murphyDeffa/SEPLOS_10kWh/BMS_3.0.jpg

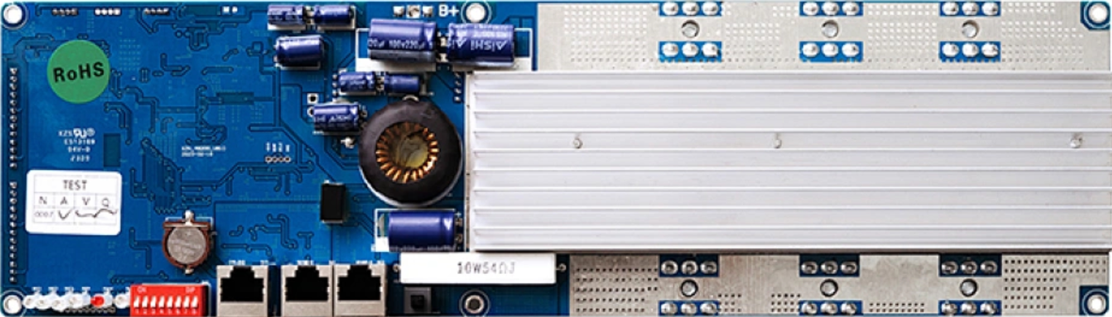
BMS_3.0.jpg
