murphyDeffa/SEPLOS_10kWh/bat1.jpg

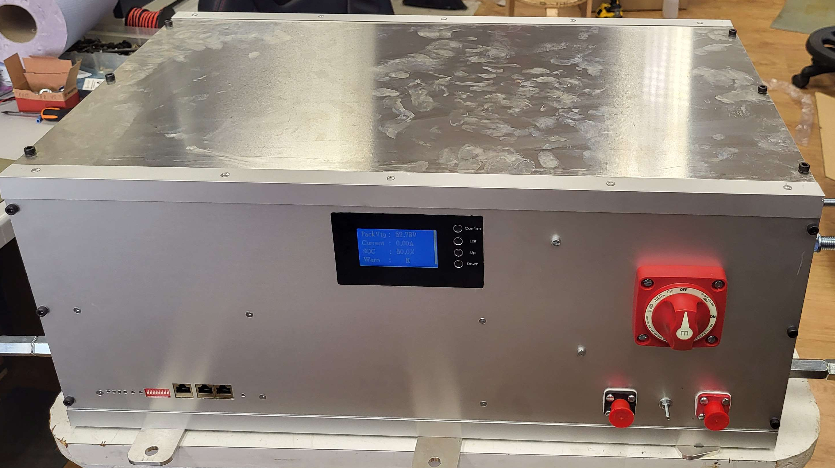
bat1.jpg
