murphyDeffa/SEPLOS_10kWh/bat3.jpg

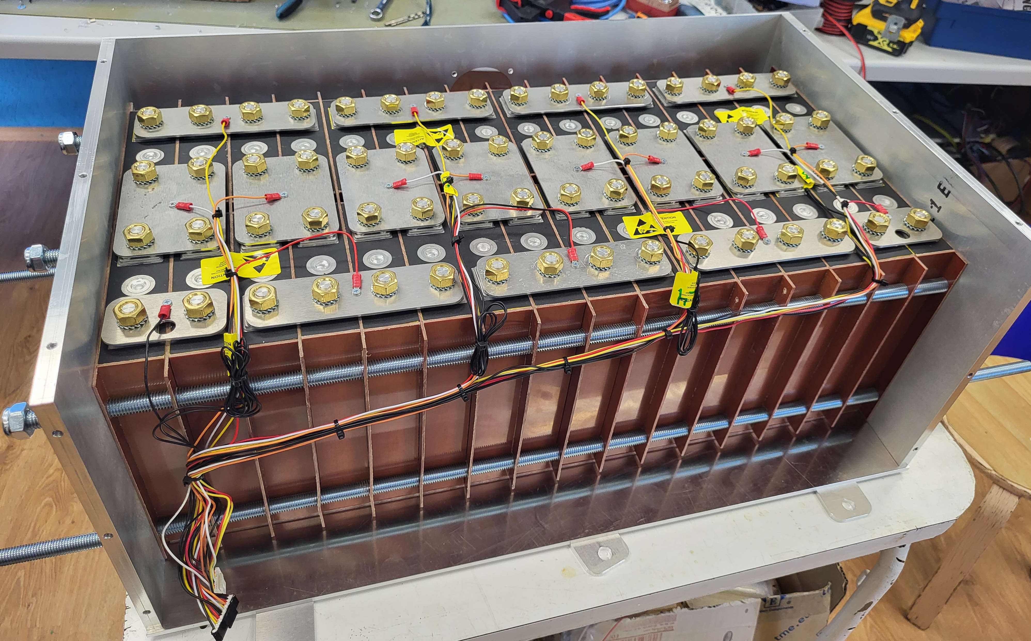
bat3.jpg
