murphyDeffa/SEPLOS_10kWh/esi_paneel.jpg

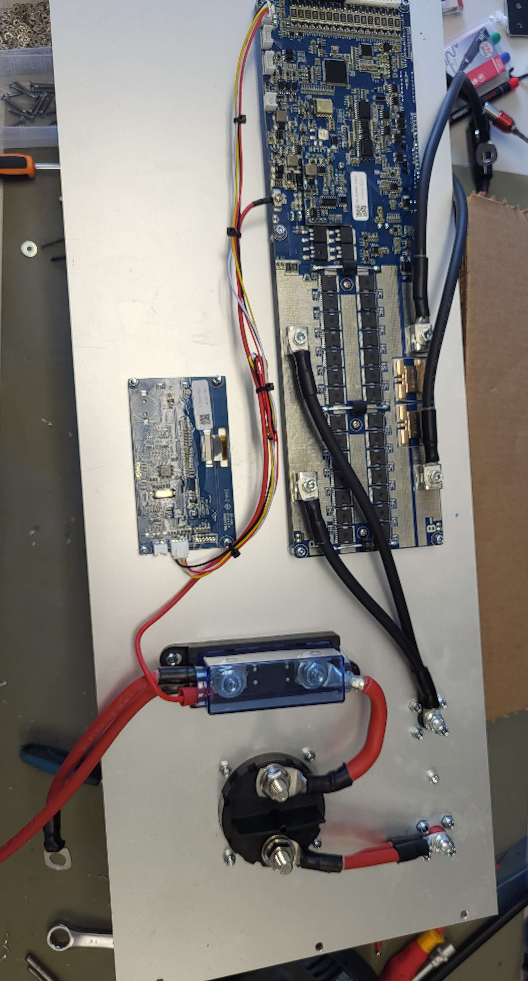
esi_paneel.jpg
