murphyDeffa/SEPLOS_10kWh/EX-L100_24V.jpg

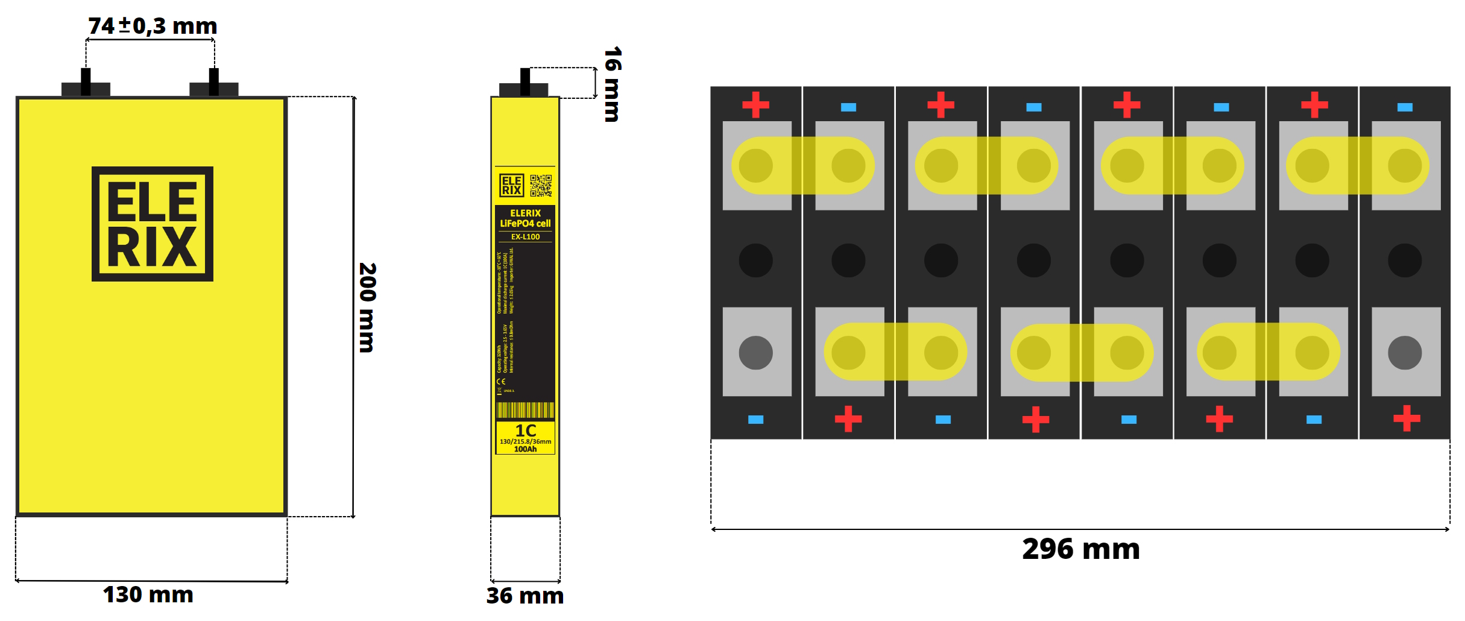
EX-L100_24V.jpg
