murphyDeffa/SEPLOS_10kWh/LDC_draw.jpg

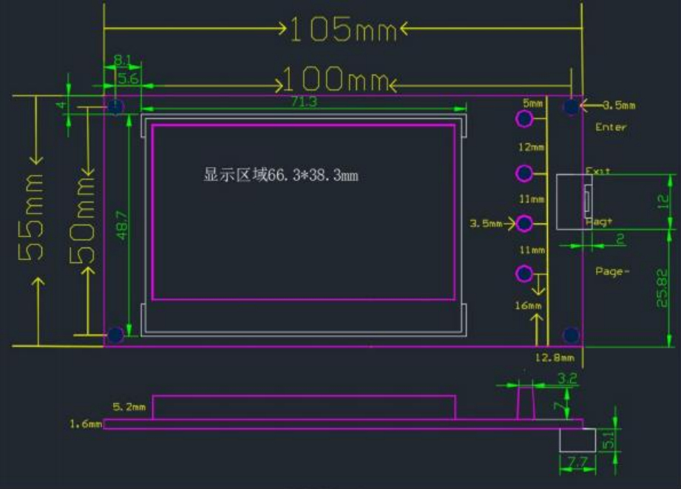
LDC_draw.jpg
