murphyDeffa/SEPLOS_10kWh/BOM.xlsx

Komponent | Kogus | Tootekood | Comment | Tarnija | Link
Tesa kahepoole teip 15-20mm | 1 rull | Aku elementide ja separaatorite vahel | punane | estpack
Nolax Aluminium comp. |  | Aku terminali ja büsbar vahel | ekvalentsed tooted leitavad eestis | amazon | https://www.amazon.com/Noalox-Anti-oxidant-Compound-Oz-Bottle/dp/B0019KHHRE
Locktight keermeliim sinine |  | kõik kinnitused v.a. Elektrilised ühendused | ekvalentsed tooted leitavad eestis | amazon | https://www.amazon.com/ThreadLocker-Fasteners-Anaerobic-Loosening-Corrosion/dp/B0CZ4GZZYH?th=1
CAD
Front_Panel | 1 | 3mm Al |  | Eccom | https://eccom.ee/
Back_Panel | 1 | 3mm Al |  | Eccom | https://eccom.ee/
Top_Panel | 1 | 3mm Al |  | Eccom | https://eccom.ee/
Bottom_Panel | 1 | 5mm Al |  | Eccom | https://eccom.ee/
End_Plate | 2 | 10mm Al |  | Eccom | https://eccom.ee/
Bus_Bar1 | 2 | 3mm Al | Anodeerimata!! | Eccom | https://eccom.ee/
Bus_Bar2 | 8 | 3mm Al | Anodeerimata!! | Eccom | https://eccom.ee/
Bus_Bar3 | 7 | 3mm Al | Anodeerimata!! | Eccom | https://eccom.ee/
Separator1 | 1 | 2mm klaas/riide tekstoliit |  | Eccom | https://eccom.ee/
Separator2 | 17 | 2mm klaas/riide tekstoliit |  | Eccom | https://eccom.ee/
Separator3 | 64 | 2mm klaas/riide tekstoliit | laius mitte väiksem kui mudelis | Eccom | https://eccom.ee/
Spacer | 6 | 0,5-1mm pleks | aku paki laiuse reguleerimiseks, kogu laius peab olema 635mm
Kinnitusmaterjalid
Al 15x15 L profiil, dekoratiivne 1M | 4 |  |  | ehituspood
3,2mm 10mm neet | 20 |  | L-profiil iluliistude kinnitamiseks | ehituspood
M10 bimetall seib. | 4 | ALCU10CS2 | Väljund terminalide vahele. | Kalitec | https://www.kabelschuhe-shop.de/Kalitec-ALCU10CS2
M10 Al pronks mutter | 64 | komplektis aku elemendiga | 20Nm momentvõtmega
10mm lukustus seib | 64 |  |  | tme
M4x10mm | 14 |  | esipaneeli pesad, kaitse, lüliti | tme
M4 lukustusmutter | 2 |  | kaise
M3x4mm | 27 | 1375547 | sense juhtmed, BMS, BMS_LCD | tme | https://www.tme.eu/ee/details/b3x4_bn388/kruvid/bossard/1375547/
M3x15mm spacer S/V | 6 | 213X15 | BMS |  | https://www.tme.eu/ee/details/tfm-m3x15_dr213/metallpuksid/dremec/213x15/
M3 spacer | 4 |  | BMS_LCD
M3 lukustusmutter | 10 |  | BMS,BMS_LCD
M12 keermelatt 1M | 6 |  | paki koos hoidvad latid | ehituspood
M12 mutter | 12 |  | paki koos hoidvad latid, 5Nm!! Keermelati kohta | ehituspood
M12 lukustus mutter | 10 |  | paki koos hoidvad latid, keerata jõuga mitte lukustuva mutri vastu | ehituspood
M12 seib | 12 |  | paki koos hoidvad latid | ehituspood
M12 pikendusmutter | 8 |  | paki koos hoidvad latid, 2 pikemat latti käepideme jaoks | ehituspood
1,5mm2 8mm kaabliking | 1 |  | BMS toide | akuladu | https://akuladu.ee/toode/juhtme-ots-680-kollane-m10/
10mm2 5mm Kaabliking | 4 |  | BMS |  | https://akuladu.ee/toode/klemm-starteri-cu-5-10/
10mm2 6mm Kaabliking | 4 |  | Esipaneel pesad | akuladu | https://akuladu.ee/toode/klemm-starteri-cu-6-10/
10mm2 8mm Kaabliking | 2 |  | kaitse | akuladu | https://akuladu.ee/toode/klemm-starteri-cu-8-10/
10mm2 10mm Kaabliking | 6 | BM 02443 | battery term. Switch | tme | https://www.tme.eu/ee/details/bm02443/isoleerimata-konnektorid/bm-group/bm-02443/
25mm2 10mm kaabliking | 1 |  | lüliti | akuladu | https://akuladu.ee/toode/klemm-starteri-cu-10-25/
25mm2 8mm kaabliking | 1 |  | kaitse | akuladu | https://akuladu.ee/toode/klemm-starteri-cu-8-25/
10mm2 kaabel punane | 1m |  | sisemised pos. ühendused | akuladu | https://akuladu.ee/toode/kaabel-kummi-10mm2-hi-flex-punane/
10mm2 kaabel must | 1m |  | sisemised neg. Ühendused | akuladu | https://akuladu.ee/toode/kaabel-kummi-10mm2-hi-flex-must/
25mm2 kaabel punane | x |  | lüliti - kaitse. Väljuv -pos. Ühendus, pikkus vastavalt vajadusele | akuladu | https://akuladu.ee/toode/kaabel-kummi-25mm2-hi-flex-punane/
25mm2 kaabel must | x |  | Väljuv neg. Ühendus, pikkus vastavalt vajadusele | akuladu | https://akuladu.ee/toode/kaabel-kummi-25mm2-hi-flex-must/
Elektroonika
EX-L100 | 32 |  |  |  | https://www.i4wifi.eu/en/298853-elerix-ex-l100
Seoplos BMS 3.0 100A LiFePo LCD | 1 |  |  | SEPLOS
Victron Fuse holder for MEGA-fuse | 1 | CIP000100001 |  | akuladu | https://akuladu.ee/toode/victron-fuse-holder-for-mega-fuse/
Victron MEGA-fuse 200A/32V | 1 |  |  | akuladu | https://akuladu.ee/toode/victron-mega-fuse-200a-32v/
must esipaneeli pesa | 1 | SLPRATPSB |  | mouser | https://www.mouser.ee/ProductDetail/Amphenol-Industrial/SLPRATPSB?qs=Rmyl20M3OaDqadhFFYsKQQ%3D%3D
punane esipaneeli pesa | 1 | SLPRATPSR |  | mouser | https://www.mouser.ee/ProductDetail/Amphenol-Industrial/SLPRATPSR?qs=Rmyl20M3OaBR9uqyp%252BGgEA%3D%3D
must pistik 25mm2 kaablile | 1 | SLPPA25BSB |  | mouser
punane pistik 25mm2 kaablile | 1 | SLPPA25BSR |  | mouser
Toitelüliti | 1 |  |  | akuladu | https://akuladu.ee/toode/massiluliti-12-48v-300a-1500a/
