murphyDeffa/SEPLOS_10kWh/Battery_Back.SLDASM

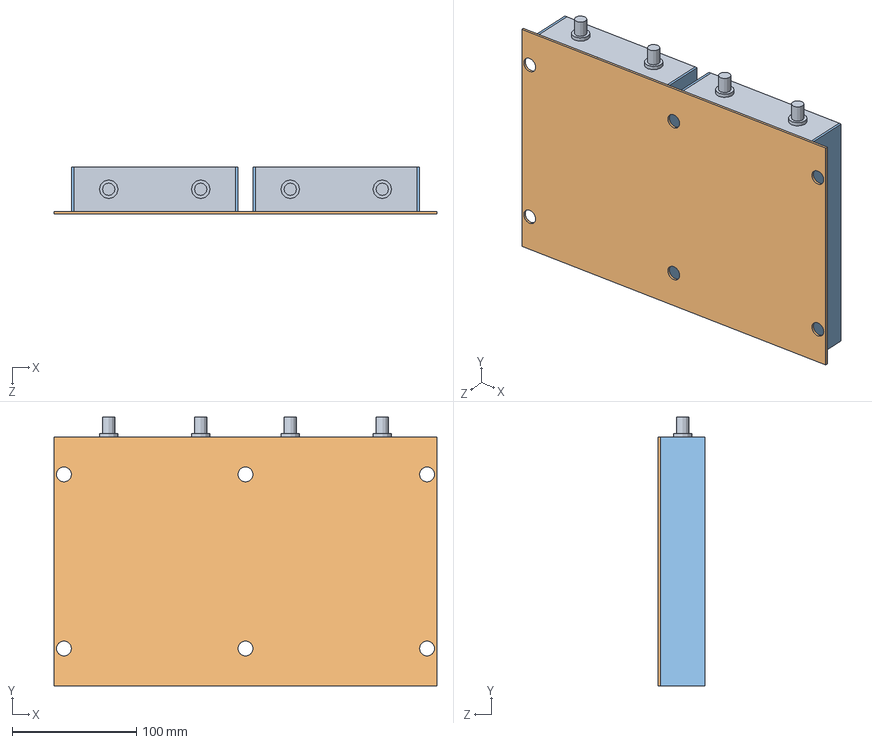
[picture p7: CAD file, 2025-07-07]
Battery_Back.SLDASM
308.0 x 216.0 x 38.0 mm
Battery x 2
Separator2
Separator3 x 4
