murphyDeffa/SEPLOS_10kWh/Spacer.STEP

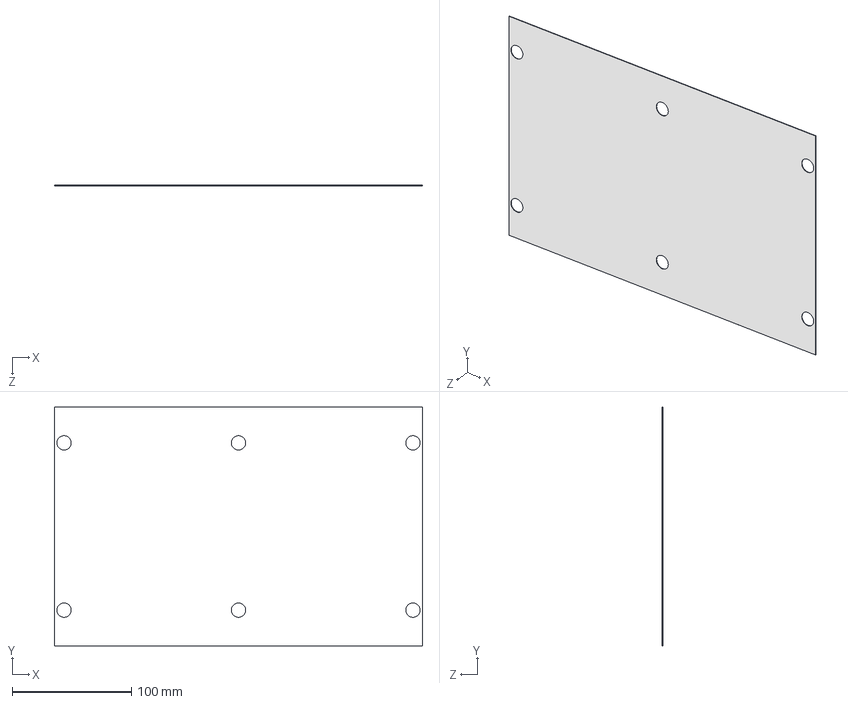
[picture p8: CAD file, 2025-07-06]
Spacer.STEP
308.0 x 200.0 x 0.5 mm
