murphyDeffa/SEPLOS_10kWh/Front_Panel.STEP

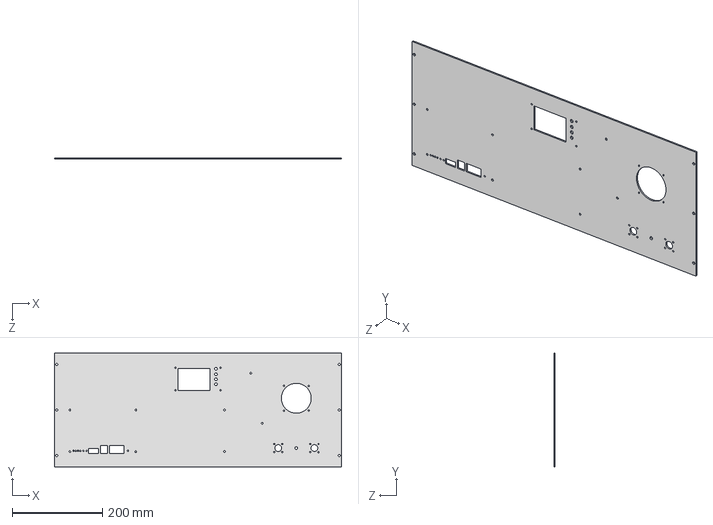
[picture p9: CAD file, 2025-07-06]
Front_Panel.STEP
635.0 x 252.0 x 3.00 mm
