murphyDeffa/SEPLOS_10kWh/Battery_Pack32.STEP

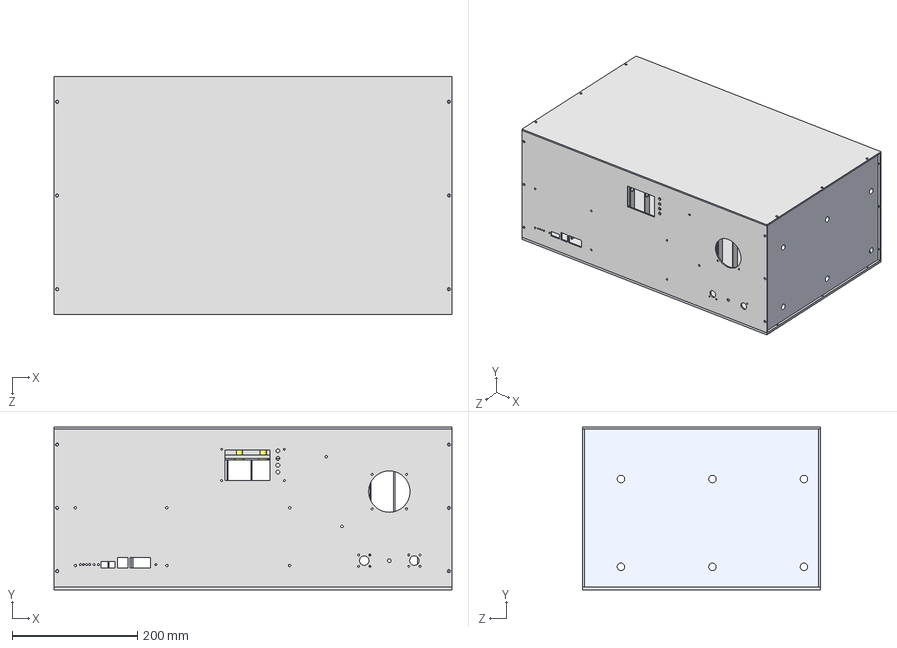
[picture p10: CAD file, 2025-07-06]
Battery_Pack32.STEP
635.0 x 260.0 x 379.0 mm
Battery x 32
Separator2 x 17
Separator3 x 64
End_Plate x 2
Separator1
Bus_Bar1 x 2
Bus_Bar2 x 8
Bus_Bar3 x 7
Front_Panel
Read_Panel
Bottom_Panel
Top_Panel
