murphyDeffa/SEPLOS_10kWh/Bus_Bar1.STEP

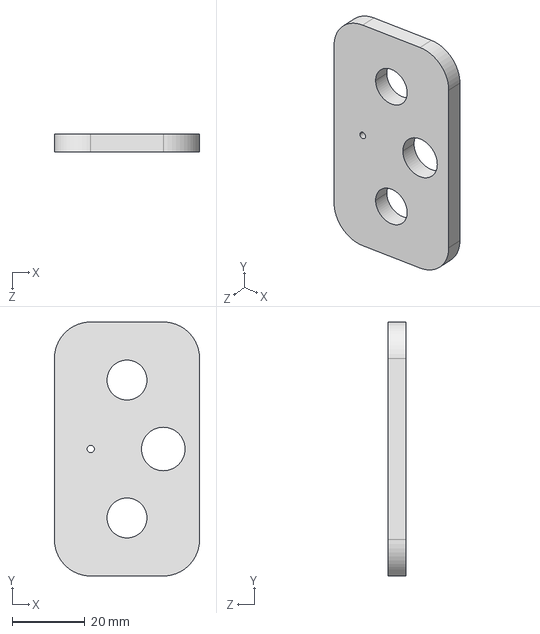
[picture p11: CAD file, 2025-07-06]
Bus_Bar1.STEP
40.0 x 70.0 x 5.00 mm
