murphyDeffa/SEPLOS_10kWh/Bottom_Panel.STEP

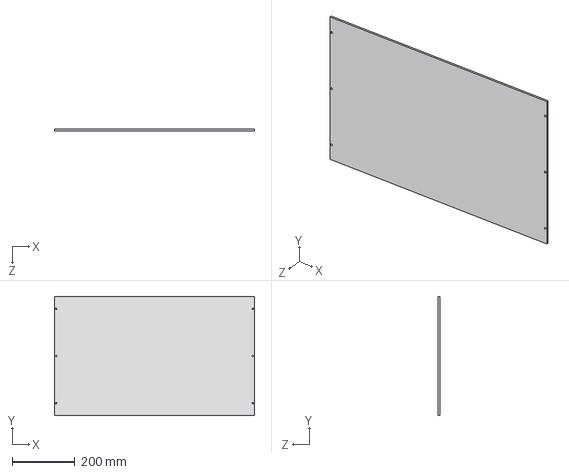
[picture p12: CAD file, 2025-07-06]
Bottom_Panel.STEP
635.0 x 379.0 x 5.00 mm
