murphyDeffa/SEPLOS_10kWh/Top_Panel.STEP

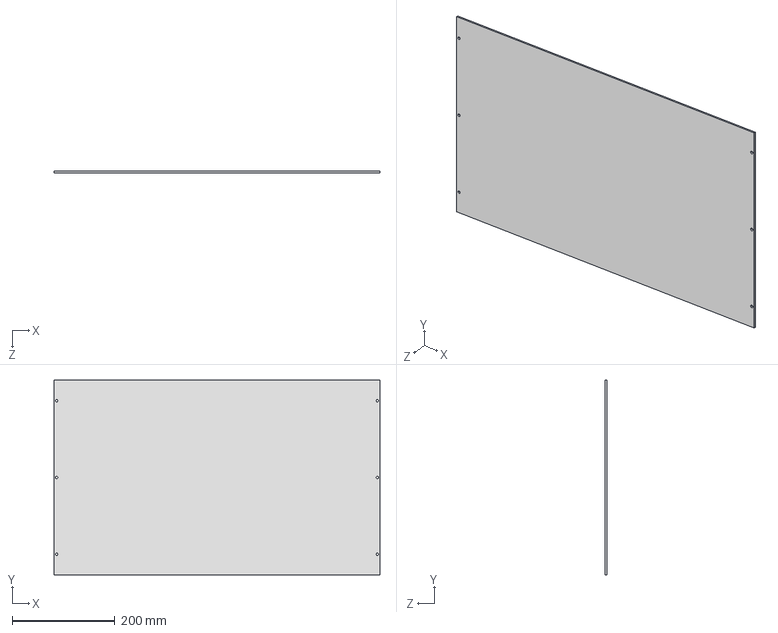
[picture p13: CAD file, 2025-07-06]
Top_Panel.STEP
635.0 x 379.0 x 3.00 mm
