murphyDeffa/SEPLOS_10kWh/Separator1.STEP

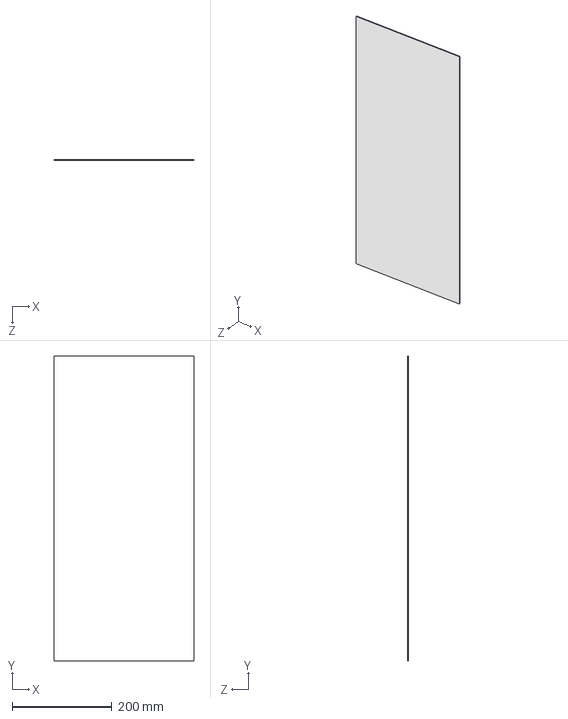
[picture p14: CAD file, 2025-07-06]
Separator1.STEP
280.0 x 610.0 x 2.00 mm
