murphyDeffa/SEPLOS_10kWh/Separator3.STEP

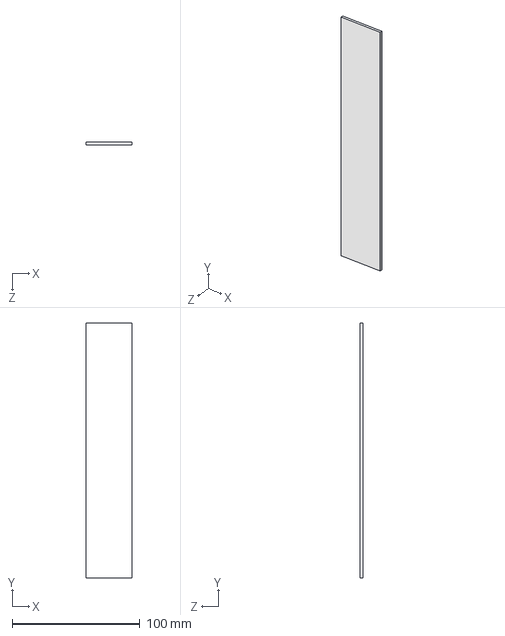
[picture p15: CAD file, 2025-07-06]
Separator3.STEP
36.0 x 200.0 x 2.00 mm
