murphyDeffa/SEPLOS_10kWh/End_Plate.STEP

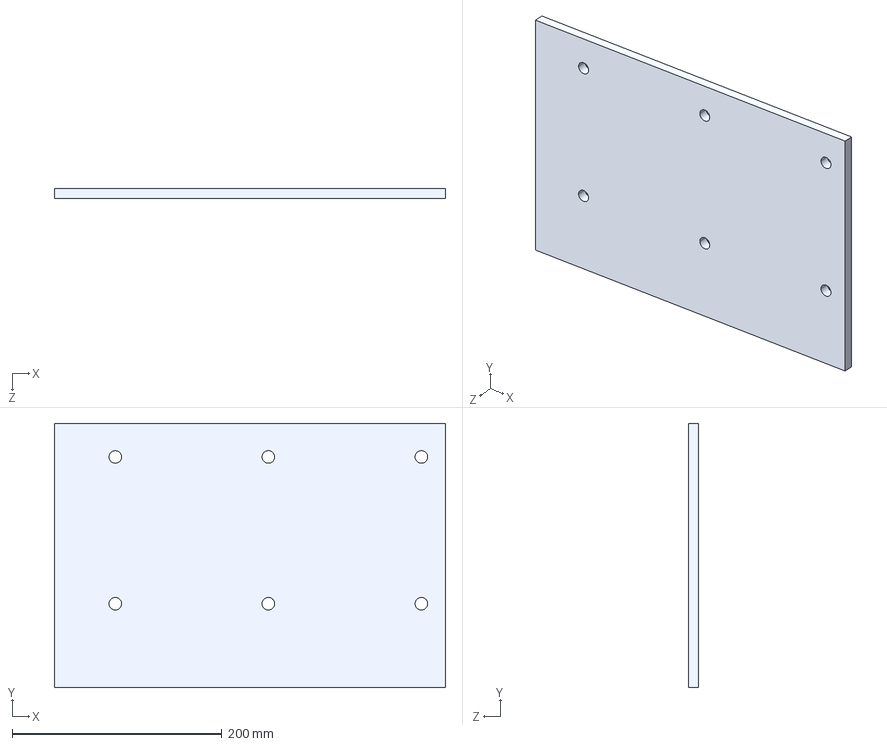
[picture p16: CAD file, 2025-07-06]
End_Plate.STEP
373.0 x 252.0 x 10.0 mm
