murphyDeffa/SEPLOS_10kWh/Bus_Bar3.STEP

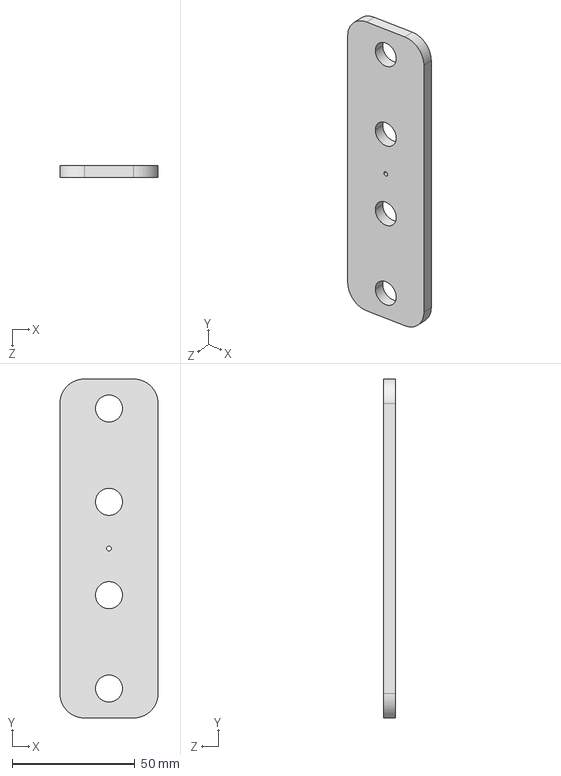
[picture p17: CAD file, 2025-07-06]
Bus_Bar3.STEP
40.0 x 138.0 x 5.00 mm
