murphyDeffa/SEPLOS_10kWh/Rear_Panel.STEP

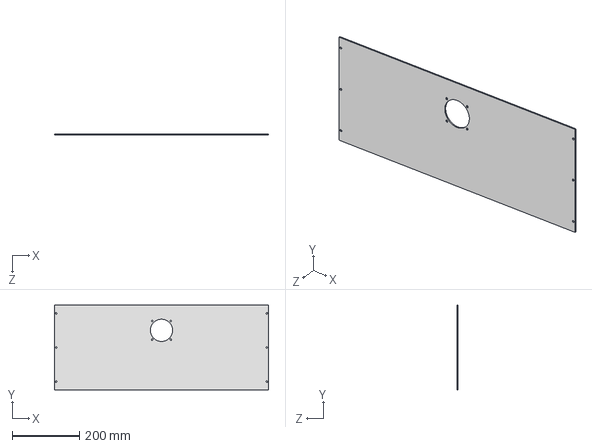
[picture p18: CAD file, 2025-07-06]
Rear_Panel.STEP
635.0 x 252.0 x 3.00 mm
