murphyDeffa/SEPLOS_10kWh/Separator2.STEP

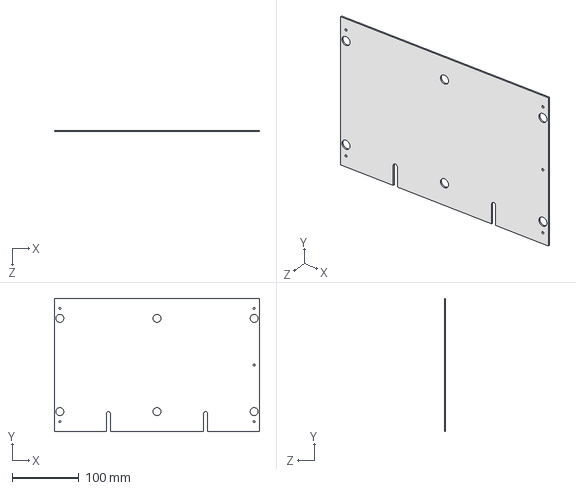
[picture p19: CAD file, 2025-07-06]
Separator2.STEP
308.0 x 200.0 x 2.00 mm
