murphyDeffa/SEPLOS_10kWh/Bus_Bar2.STEP

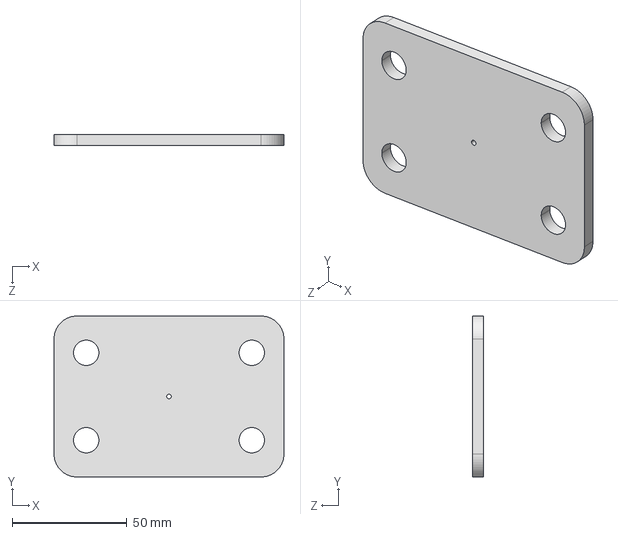
[picture p20: CAD file, 2025-07-06]
Bus_Bar2.STEP
100.0 x 70.0 x 5.00 mm
