murphyDeffa/SEPLOS_10kWh/(list of files, cad)

Other CAD files:
SEPLOS48200.dwg
